BitsUndBolts/airmeter/ESP32_C3_SuperMini/data/mm_bub.webp

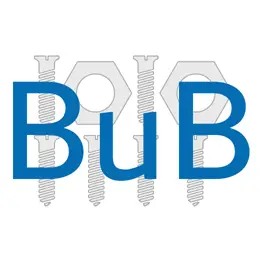
ESP32_C3_SuperMini/data/mm_bub.webp
