BitsUndBolts/airmeter/Screens/10 Glacier.png

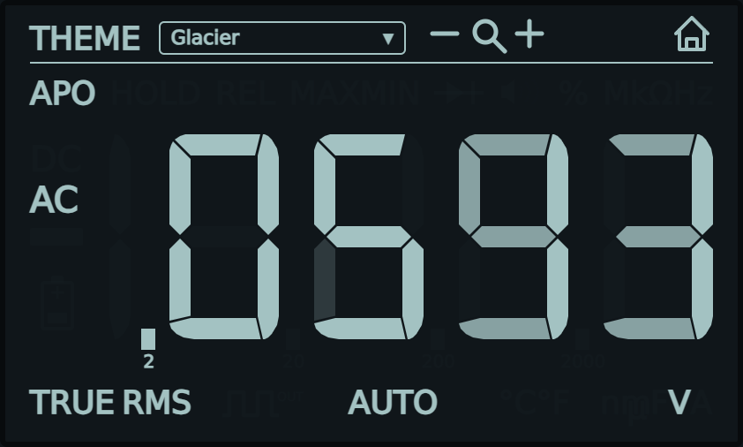
Screens/10 Glacier.png
