BitsUndBolts/airmeter/Screens/11 Sport.png

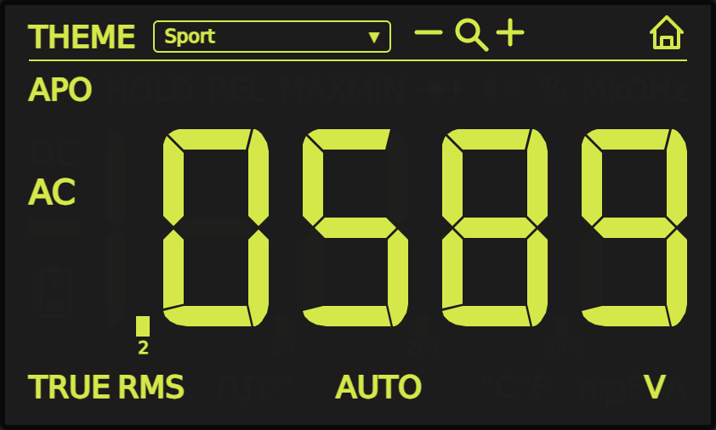
Screens/11 Sport.png
