BitsUndBolts/airmeter/Screens/12 Blue Wave.png

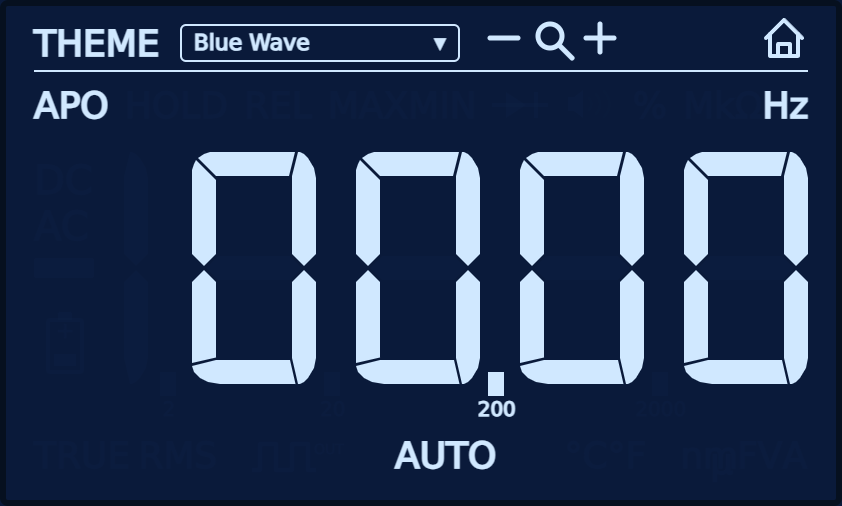
Screens/12 Blue Wave.png
