BitsUndBolts/airmeter/Screens/OTA Upload and Flashing.jpg

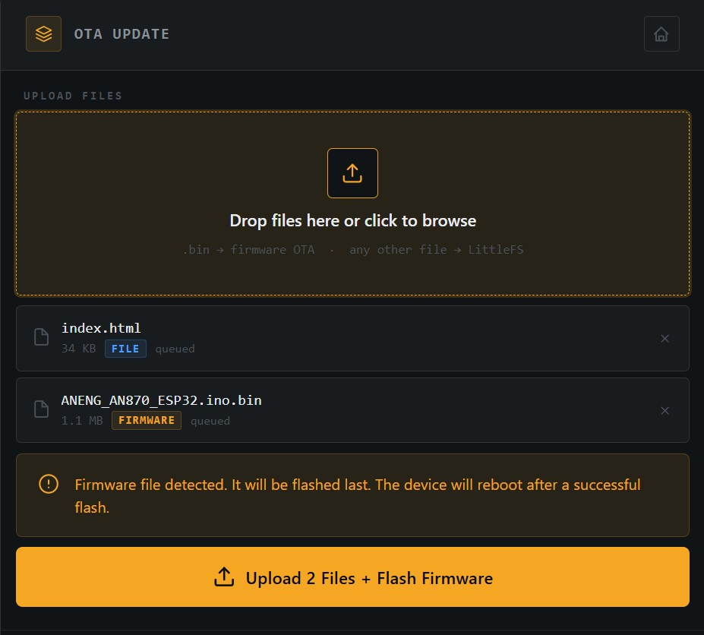
Screens/OTA Upload and Flashing.jpg
