BitsUndBolts/airmeter/PCB/BOM_Wireless-Multimeter-v1.4_2026-07-09.csv

ID | Name | Designator | Footprint | Quantity | Part | Value
1 | C0603 | C18,C14,C12,C11,C10,C2,C7,C8,C5,C6,C9,C4 | C0603 | 12 | Capacitor | 100nF
2 | C0805 | C17 | C0805 | 1 | Capacitor | 10uF
3 | C1206 | C16 | C1206 | 1 | Capacitor | 22uF
4 | L0805 | FB1 | L0805 | 1 | Ferrite Bead 100R @ 100MHz | 100R
5 | C0603 | C15,C13,C1,C3 | C0603 | 4 | Capacitor | 2.2uF
7 | R0603 | R1 | R0603 | 1 | Resistor | 270KΩ
8 | R0603 | R2,R3 | R0603 | 2 | Resistor | 1MΩ
9 | TSSOP-14_L5.0-W4.4-P0.65-LS6.4-BL | U5,U4,U3,U2,U1 | TSSOP-14_L5.0-W4.4-P0.65-LS6.4-BL | 5 | LM339LVPWR
10 | R0603 | R4 | R0603 | 1 | Resistor | 200kΩ
