BitsUndBolts/airmeter/Setup Arduino IDE.docx

Step 1: Install the Plugin on Windows

1. Navigate to the arduino-littlefs-upload Releases Page (https://github.com/earlephilhower/arduino-littlefs-upload/releases) in your web browser.
2. Download the compiled file ending with the extension .vsix (e.g., arduino-littlefs-upload-X.X.X.vsix).
3. Close Arduino IDE 2.x completely.
4. Open Windows File Explorer and navigate to your local workspace plugins target directory: C:\Users\<YOUR_WINDOWS_USERNAME>\.arduinoIDE\
5. Check if a folder named plugins exists inside .arduinoIDE. If it does not exist, right-click, create a new folder, and name it exactly plugins.
6. Copy and paste the downloaded .vsix file into that plugins folder. [1 (https://github.com/earlephilhower/arduino-littlefs-upload)]

Step 2: Flash Your Frontend Assets Folder

1. Reopen your Arduino IDE 2.x.
2. Confirm your project structure contains your asset file natively on Windows:

text

Documents/Arduino/ANENG_AN870_Project/

├── ANENG_AN870_Project.ino

└── data/

└── setup.html

Use code with caution.

3. Ensure your ESP32-C3 is selected in your IDE target dropdown toolbar and connected to your PC over USB.
4. CRITICAL STEP: Close your Serial Monitor window inside the IDE interface (the plugin will fail if the port is busy).
5. Press Ctrl + Shift + P on your keyboard to open the Command Palette.
6. Type LittleFS into the prompt selection bar.
7. Click Upload LittleFS to Pico/ESP8266/ESP32. [, 2 (https://support.arduino.cc/hc/en-us/articles/4733418441116-Upload-a-sketch-in-Arduino-IDE), 3 (https://support.arduino.cc/hc/en-us/articles/4403365313810-If-your-sketch-doesn-t-upload)]

The command console at the bottom will compile your data folder into a clean file-system image binary file and push it down to your chip. [, 2 (https://www.youtube.com/watch?v=--ntyx4e-p8)]

ADDITIONAL BOARDS MANAGER URLS (File > Preferences):

https://adafruit.github.io/arduino-board-index/package_adafruit_index.json

https://files.seeedstudio.com/arduino/package_seeeduino_boards_index.json

https://github.com/earlephilhower/arduino-pico/releases/download/global/package_rp2040_index.json

https://raw.githubusercontent.com/pdcook/nRFMicro-Arduino-Core/main/package_nRFMicro_index.json

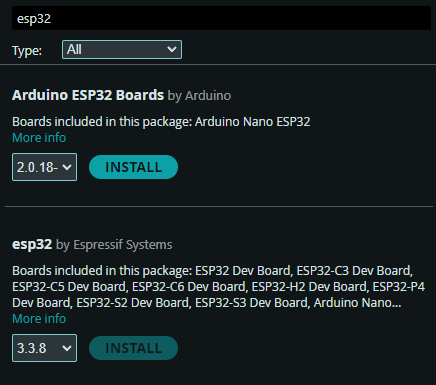
[picture p20: figure]

Libraries to install:

ESP Async WebServer by ESP32Async (currently version 3.11.0)

Async TCP by ESP32Async (currently version 3.4.10).
