BitsUndBolts/airmeter/PCB/Schematic_Wireless-Multimeter.pdf

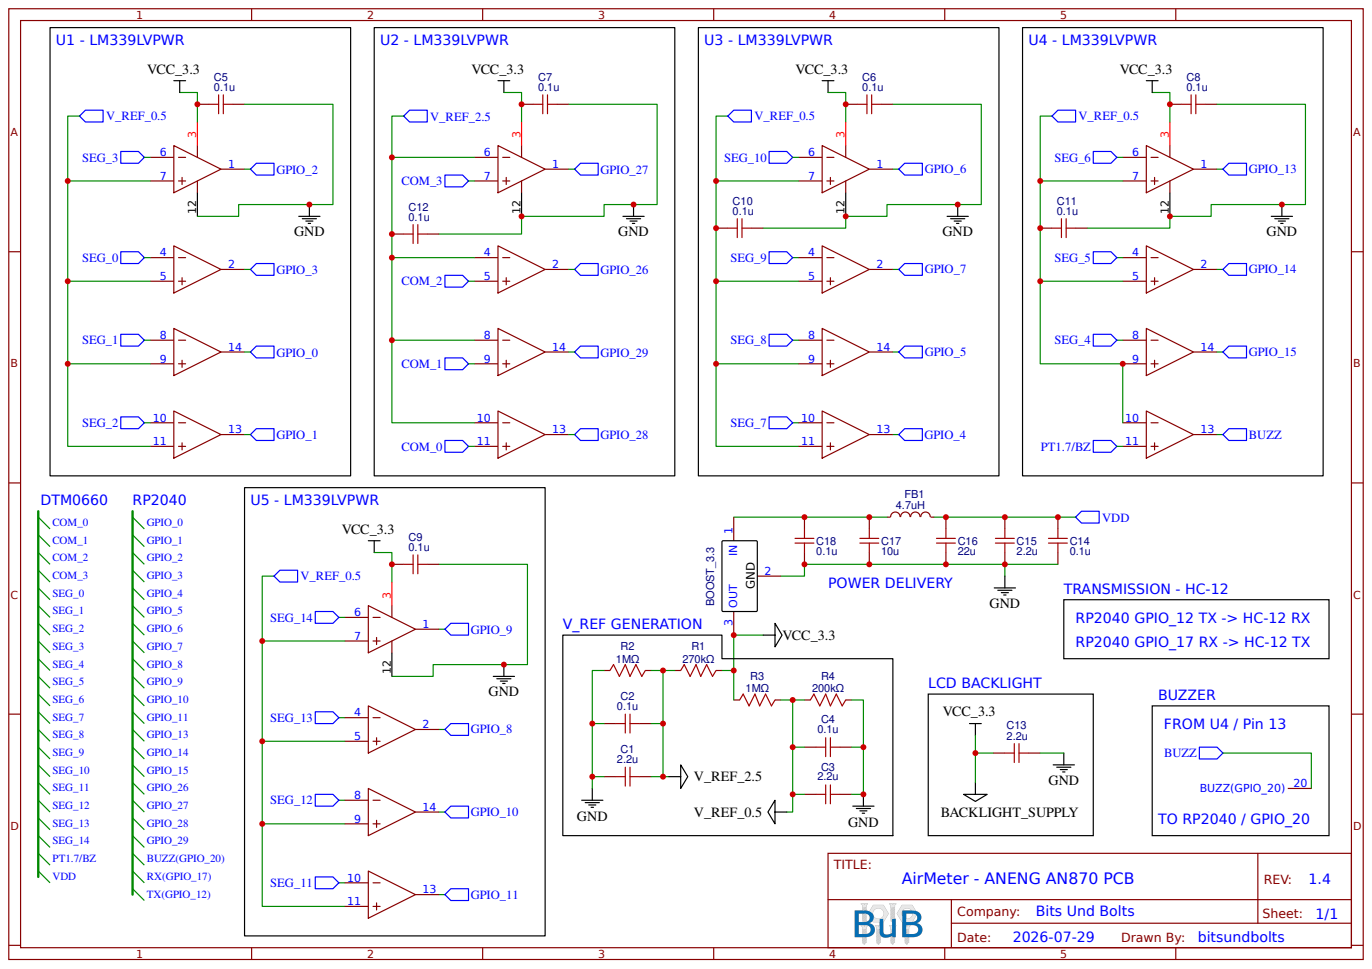
[picture p21: page 1]

Company: Bits Und Bolts
