BitsUndBolts/airmeter/(commit log)

2026-06-13 BOOT button to cycle through frame rates
2026-06-14 Boot Button Debounce and Buzzer Latch
    [RP2040_Zero.ino]
2026-06-14 Integrate META byte into ESP32 core
2026-06-15 Home Button in MeterConfig page
2026-06-15 Two Way communication from ESP32 to RP2040 implemented
2026-06-17 Consolidate Button styles
2026-06-17 Remove Refresh rate from local ESP32 storage
2026-06-17 Replace Meter ID with Channel
    [ESP32_C3_SuperMini.ino, RP2040_Zero.ino]
2026-06-18 Upgrade HC-12 Diagnostic and programming tool for Arduino UNO
2026-06-19 Improve RP2040 COM and SEG reading - skip broken numbers
    [Arduino_UNO_HT-12.ino, RP2040_Zero.ino]
2026-06-19 POWER SAVE - do not send duplicate screen readings
2026-06-19 Meters in Power Conservation mode will not disappear from dashboard
2026-06-20 Remove cooloff logic - no longer needed
    [ESP32_C3_SuperMini.ino]
2026-06-21 Adding Gerber Files, BOM, and update README
    [BOM.csv]
2026-06-22 Adding ESP32 hardware details
2026-06-22 Show ESP32 hardware details
2026-06-23 Include ESP32 Model specific details
2026-06-23 Web Serial Flasher for ESP32 and updated README
2026-06-23 ESP32 Installer Update
2026-06-23 Make Install Button for Firmware work
2026-06-23 Add favicon to ESP32 installer
2026-06-23 Indicator change when ESP32 is connected
2026-06-23 Detect ESP32 after permission
2026-06-23 Change BOM to LM339LV
    [BOM.csv]
2026-06-25 Enable WiFi power saving to drop temperature and fix bug switching to AP mode after flashing
    [ESP32_C3_SuperMini.ino]
2026-06-26 Changelog v1.0 → v1.1: - Fix: Brownout on AP start after flash (ESP32-C3 SuperMini power issue). WiFi.softAPdisconnect()/disconnect() before mode switch + TX power clamped to WIFI_POWER_8_5dBm before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
    [ESP32_C3_SuperMini.ino]
2026-06-26 Fix FU4 communication test
    [Arduino_UNO_HT-12.ino]
2026-06-26 Enable gzip content and replace favicon
    [ESP32_C3_SuperMini.ino]
2026-06-27 Remove Power Saving again and revamp Diagnostics
2026-06-28 Introduce changeable WiFi Power Setting
2026-07-09 Update Gerber Files
    [BOM.csv, BOM_Wireless-Multimeter_2026-07-09.csv]
2026-07-14 Adding wiring section
2026-07-17 Make ESP32 Installer detect WebSerial support in browser
2026-07-17 Make ESP32 installer detect WebSerial support in browser (#12)
    * Update README.md (#11)
    Firefox added support for WebSerial in version 151
    https://hacks.mozilla.org/2026/05/web-serial-support-in-firefox/
    * Make ESP32 Installer detect WebSerial support in browser
    ---------
2026-07-17 Include PCBWay order link
2026-07-29 Add Schematic
2026-08-08 Issue #18 - Incorrect VREF resistor value suffixes on schematic
